buq2/audible_altimeter/README.md

# audible_altimeter

KiCad schematics for electronic skydiving altimeter.

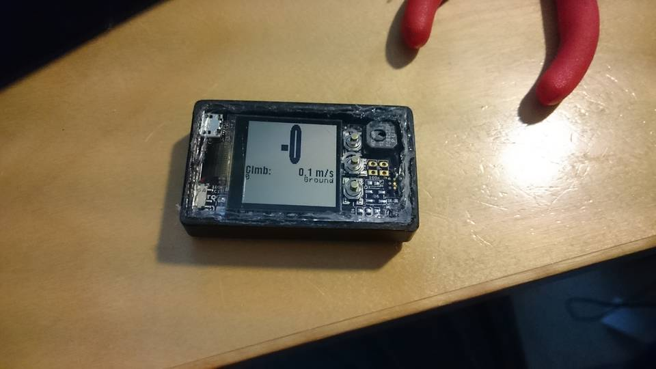
[picture p1: images/small_case13.jpg]

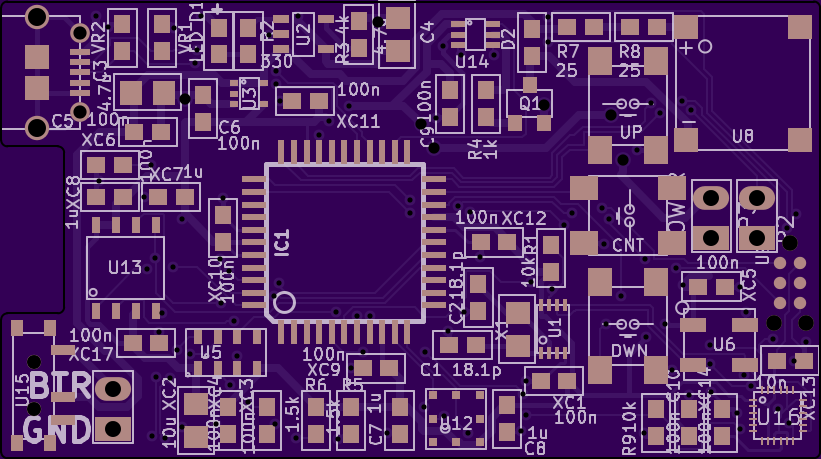
[picture p2: images/i.png]

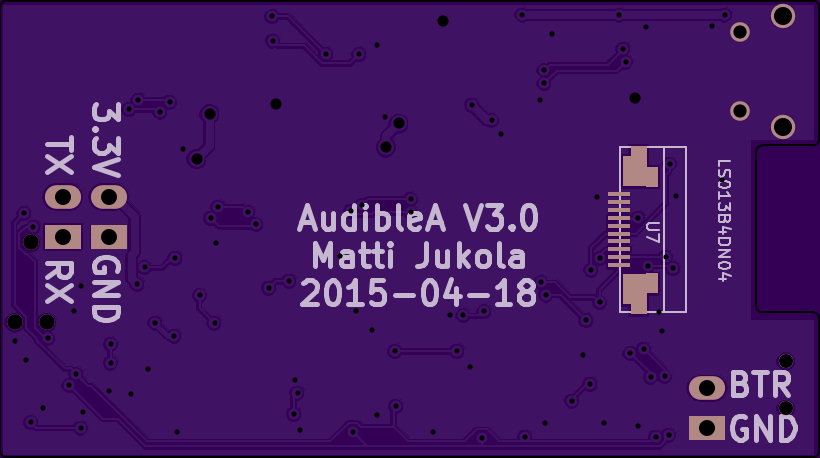
[picture p3: images/i2.png]


More information at http://buq2.com/
