buq2/audible_altimeter/case/readme.txt

http://www.makercase.com/

Thickness 1 - Inside
Width 30
Height 11.5
Depth 53
Finger
Tab width 2mm
Line stroke width 0.01
Laser cutting Kerf 0 / 0.1 / 0.15 mm
Line Color: #0000FF
Ok
