buq2/audible_altimeter/audible_altimeter.kicad_pcb

## KiCad design audible_altimeter.kicad_pcb (2016-03-05)

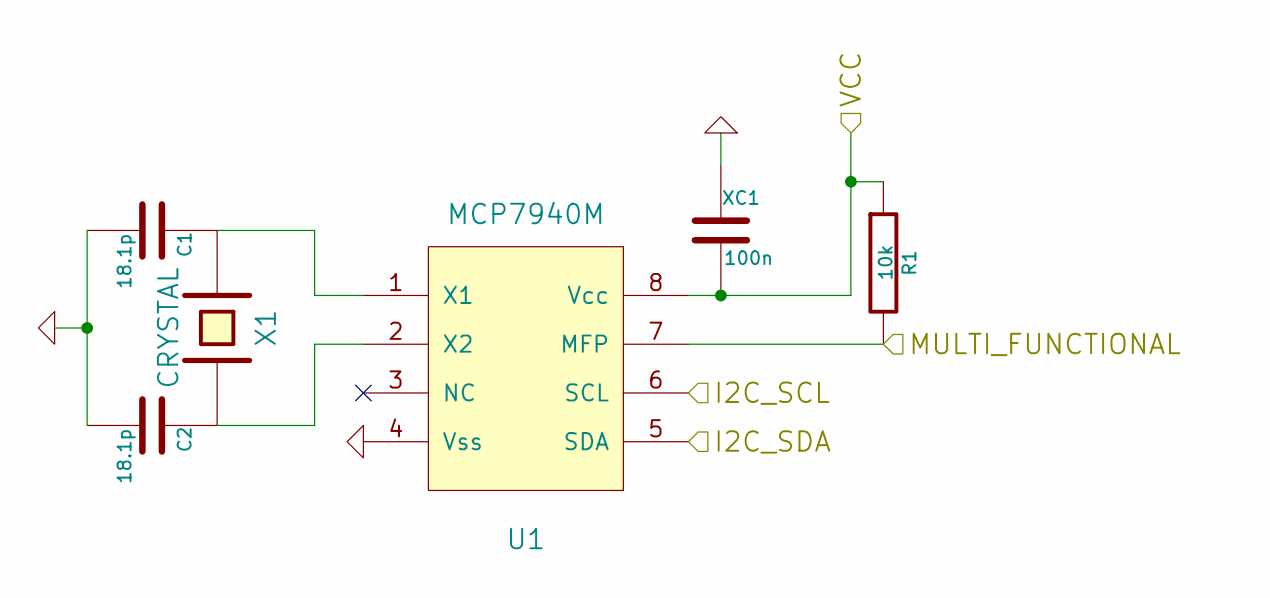
[picture p4: schematic clock.sch]

Parts:
C1, C2: 18.1p; SM0603
R1: 10k; SM0603
U1: MCP7940M; 8-TDFN
X1: CRYSTAL; SM0805
XC1: 100n; SM0603

Connections:
/Barometer/I2C_SCL: U1.6 (SCL); also elsewhere on the board
/Barometer/I2C_SDA: U1.5 (SDA); also elsewhere on the board
/Battery/+3.3V: R1.1, U1.8 (Vcc), XC1.2; also elsewhere on the board
/MCU/CLOCK_INT: R1.2, U1.7 (MFP); also elsewhere on the board
GND: C1.2, C2.2, U1.4 (Vss), XC1.1; also elsewhere on the board
unnamed: C1.1, U1.1 (X1), X1.1
unnamed: C2.1, U1.2 (X2), X1.2

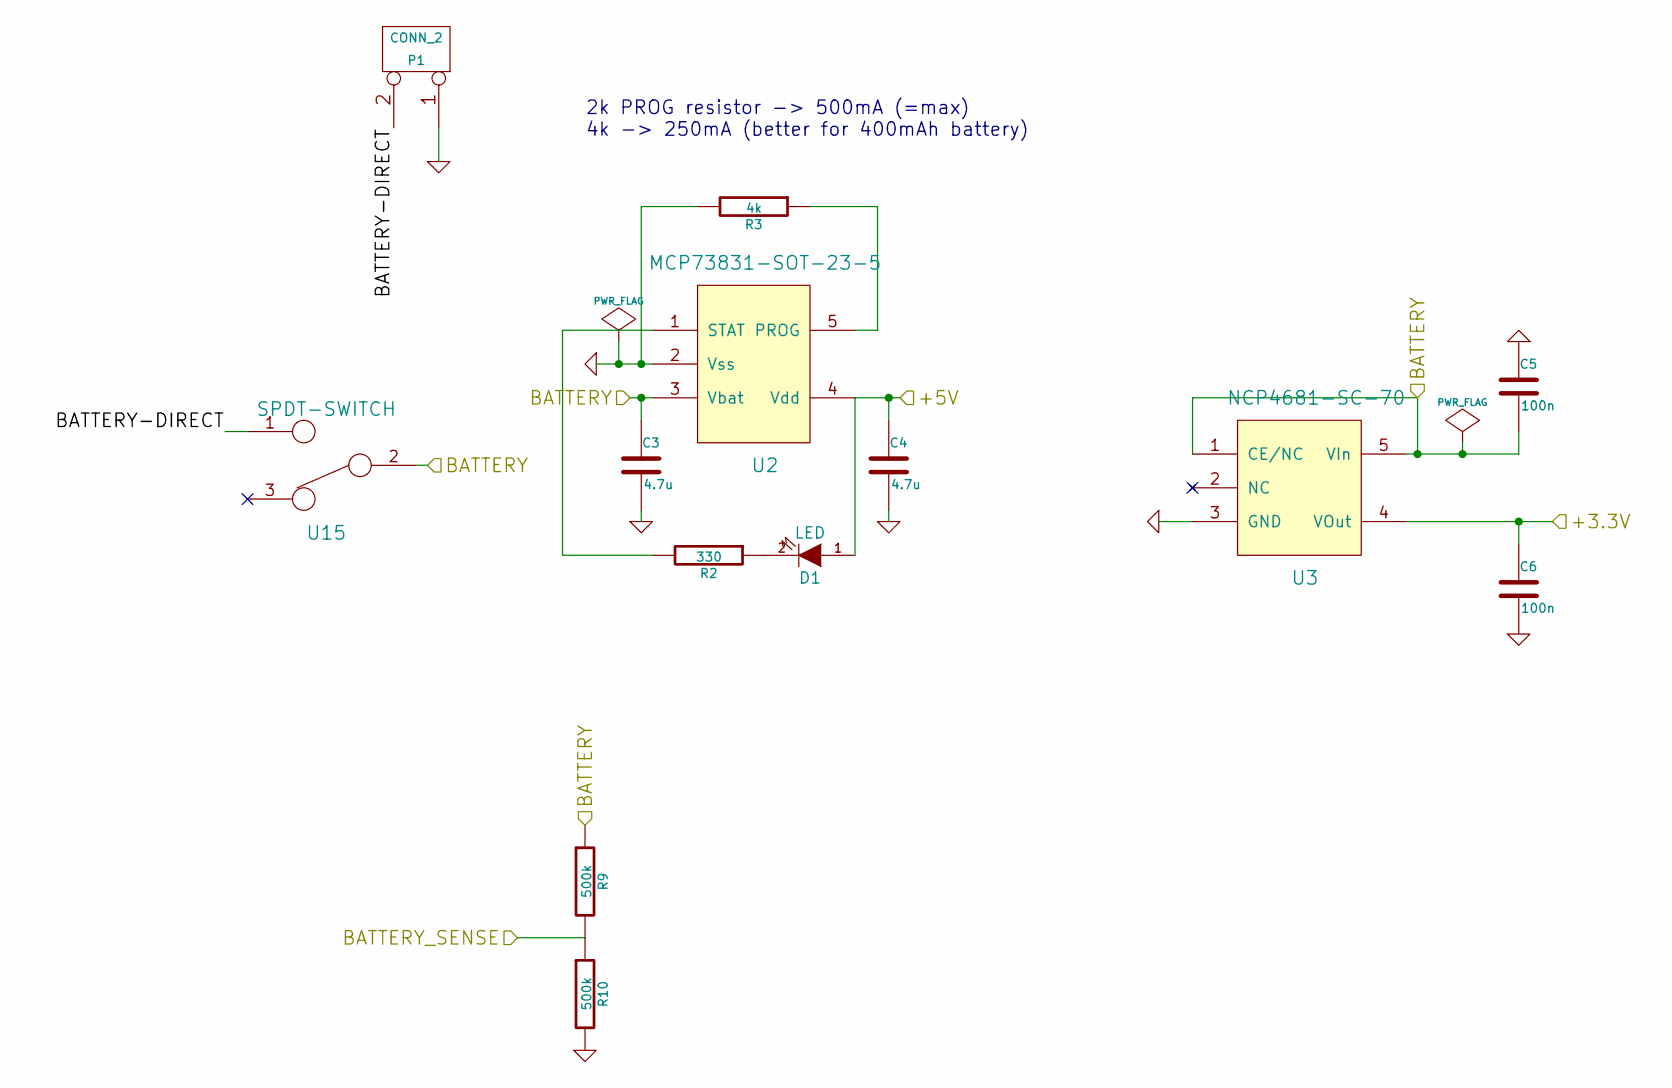
[picture p5: schematic batter.sch]

Parts:
C3, C4: 4.7u; SM0805
C5, C6: 100n; SM0603
D1: LED; SM0603
P1: CONN_2; PIN_HEADER_2
R2: 330; SM0603
R3: 4k; SM0603
R9, R10: 500k; SM0603
U2: MCP73831-SOT-23-5; SOT-23-5
U3: NCP4681-SC-70; SOT-353
U15: SPDT-SWITCH; CUS-12TB-SWITCH

Connections:
/Battery/+3.3V: C6.1, U3.4 (VOut); also elsewhere on the board
/Battery/+5V: C4.1, D1.1 (A), U2.4 (Vdd); also elsewhere on the board
/Battery/BATTERY: C3.1, C5.2, R9.1, U2.3 (Vbat), U3.1 (CE/NC), U3.5 (VIn), U15.2; also elsewhere on the board
/Battery/BATTERY-DIRECT: P1.2 (PM), U15.1
/Battery/BATTERY_SENSE: R9.2, R10.1; also elsewhere on the board
GND: C3.2, C4.2, C5.1, C6.2, P1.1, R3.2, R10.2, U2.2 (Vss), U3.3 (GND); also elsewhere on the board
unnamed: D1.2 (K), R2.1
unnamed: R2.2, U2.1 (STAT)
unnamed: R3.1, U2.5 (PROG)

Notes on the sheet:
2k PROG resistor -> 500mA (=max) 4k -> 250mA (better for 400mAh battery)

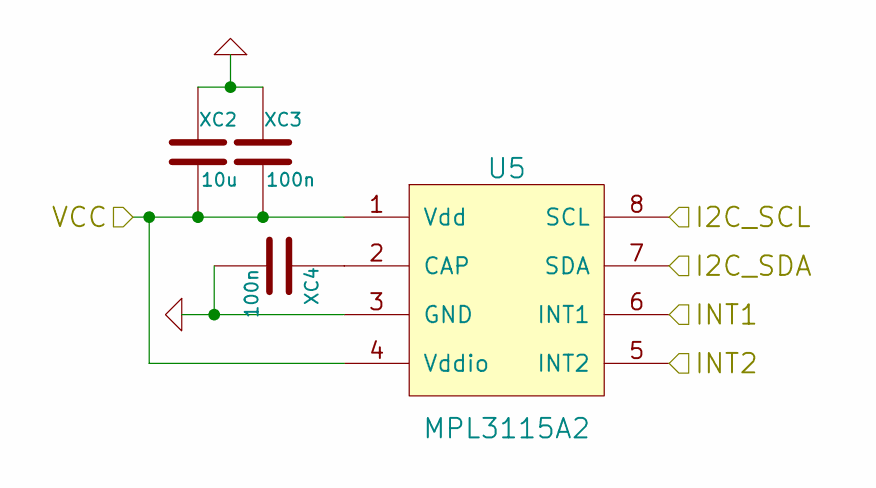
[picture p6: schematic barometer.sch]

Parts:
U5: MPL3115A2; 8-TLGA
XC2: 10u; SM0805
XC3, XC4: 100n; SM0603

Connections:
/Barometer/I2C_SCL: U5.8 (SCL); also elsewhere on the board
/Barometer/I2C_SDA: U5.7 (SDA); also elsewhere on the board
/Battery/+3.3V: U5.1 (Vdd), U5.4 (Vddio), XC2.2, XC3.2; also elsewhere on the board
/MCU/BAROMETER_INT: U5.6 (INT1); also elsewhere on the board
GND: U5.3 (GND), XC2.1, XC3.1, XC4.2; also elsewhere on the board
unnamed: U5.2 (CAP), XC4.1

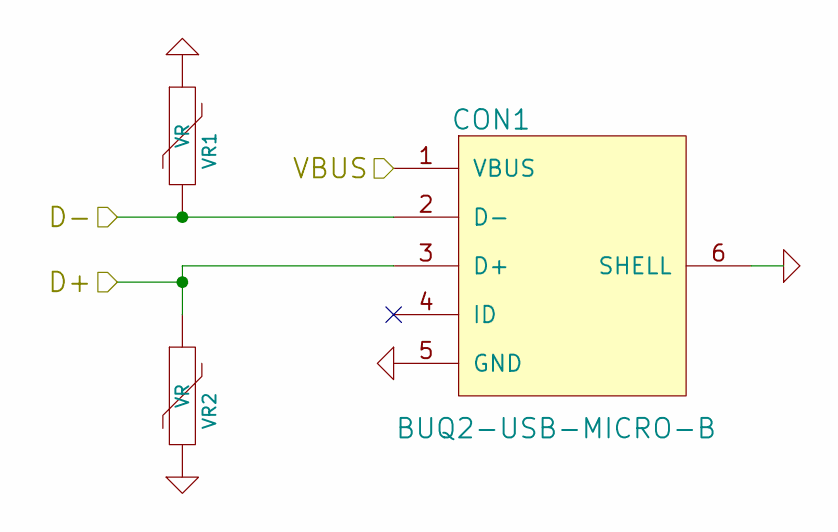
[picture p7: schematic usb.sch]

Parts:
CON1: BUQ2-USB-MICRO-B; USB-MICRO-B-FCI-10118194; Digikey 609-4616-1-ND
VR1, VR2: VR; SM0603

Connections:
/Battery/+5V: CON1.1 (VBUS); also elsewhere on the board
/MCU/D+: CON1.3 (D+), VR2.1; also elsewhere on the board
/MCU/D-: CON1.2 (D-), VR1.2; also elsewhere on the board
GND: CON1.5 (GND), CON1.6 (SHELL), VR1.1, VR2.2; also elsewhere on the board

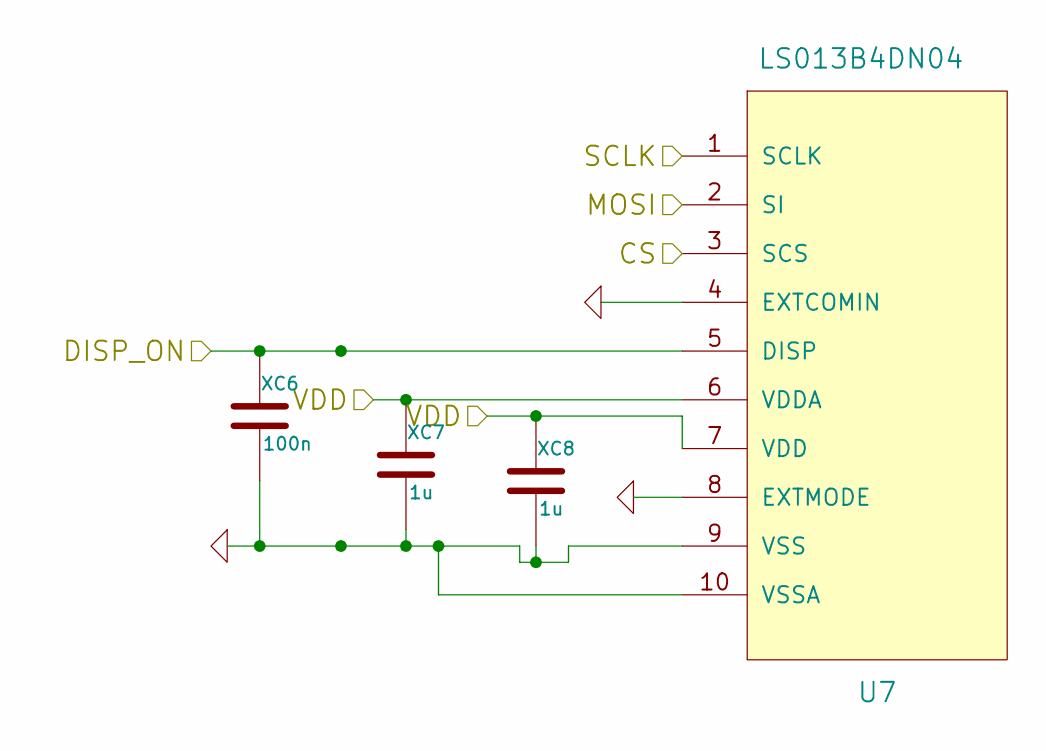
[picture p8: schematic display.sch]

Parts:
U7: LS013B4DN04; FPC-CONN-10-FCI-TOP-CONTACTS
XC6: 100n; SM0603
XC7, XC8: 1u; SM0603

Connections:
/Battery/+3.3V: U7.6 (VDDA), U7.7 (VDD), XC7.1, XC8.1; also elsewhere on the board
/Display/CS: U7.3 (SCS); also elsewhere on the board
/Display/DISP_ON: U7.5 (DISP), XC6.1; also elsewhere on the board
/Display/MOSI: U7.2 (SI); also elsewhere on the board
/MCU/SCK: U7.1 (SCLK); also elsewhere on the board
GND: U7.4 (EXTCOMIN), U7.8 (EXTMODE), U7.9 (VSS), U7.10 (VSSA), XC6.2, XC7.2, XC8.2; also elsewhere on the board

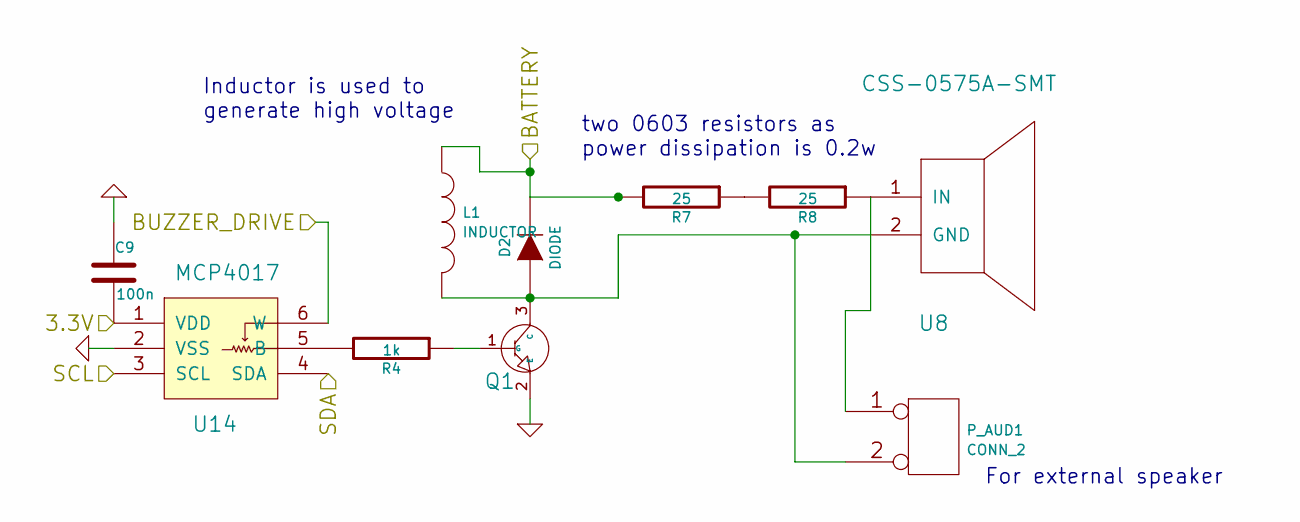
[picture p9: schematic buzzer.sch]

Parts:
C9: 100n; SM0603
D2: DIODE; SM0603
L1: INDUCTOR
P_AUD1: CONN_2
Q1: NPN-SOT23; SOT-23-3
R4: 1k; SM0603
R7, R8: 25; SM0603
U8: CSS-0575A-SMT; BUZZER-CUI-5MM
U14: MCP4017; SC-70-6

Connections:
/Barometer/I2C_SCL: U14.3 (SCL); also elsewhere on the board
/Barometer/I2C_SDA: U14.4 (SDA); also elsewhere on the board
/Battery/+3.3V: C9.2, U14.1 (VDD); also elsewhere on the board
/Battery/BATTERY: D2.2 (K), L1.1, R7.2; also elsewhere on the board
/Buzzer/BUZZER_DRIVE: U14.6 (W); also elsewhere on the board
GND: C9.1, Q1.2 (E), U14.2 (VSS); also elsewhere on the board
unnamed: D2.1 (A), L1.2, P_AUD1.2 (PM), Q1.3 (C), U8.2 (GND)
unnamed: Q1.1 (G), R4.1
unnamed: R4.2, U14.5 (B)
unnamed: R7.1, R8.2
unnamed: P_AUD1.1, R8.1, U8.1 (IN)

Notes on the sheet:
two 0603 resistors as power dissipation is 0.2w
For external speaker
Inductor is used to generate high voltage

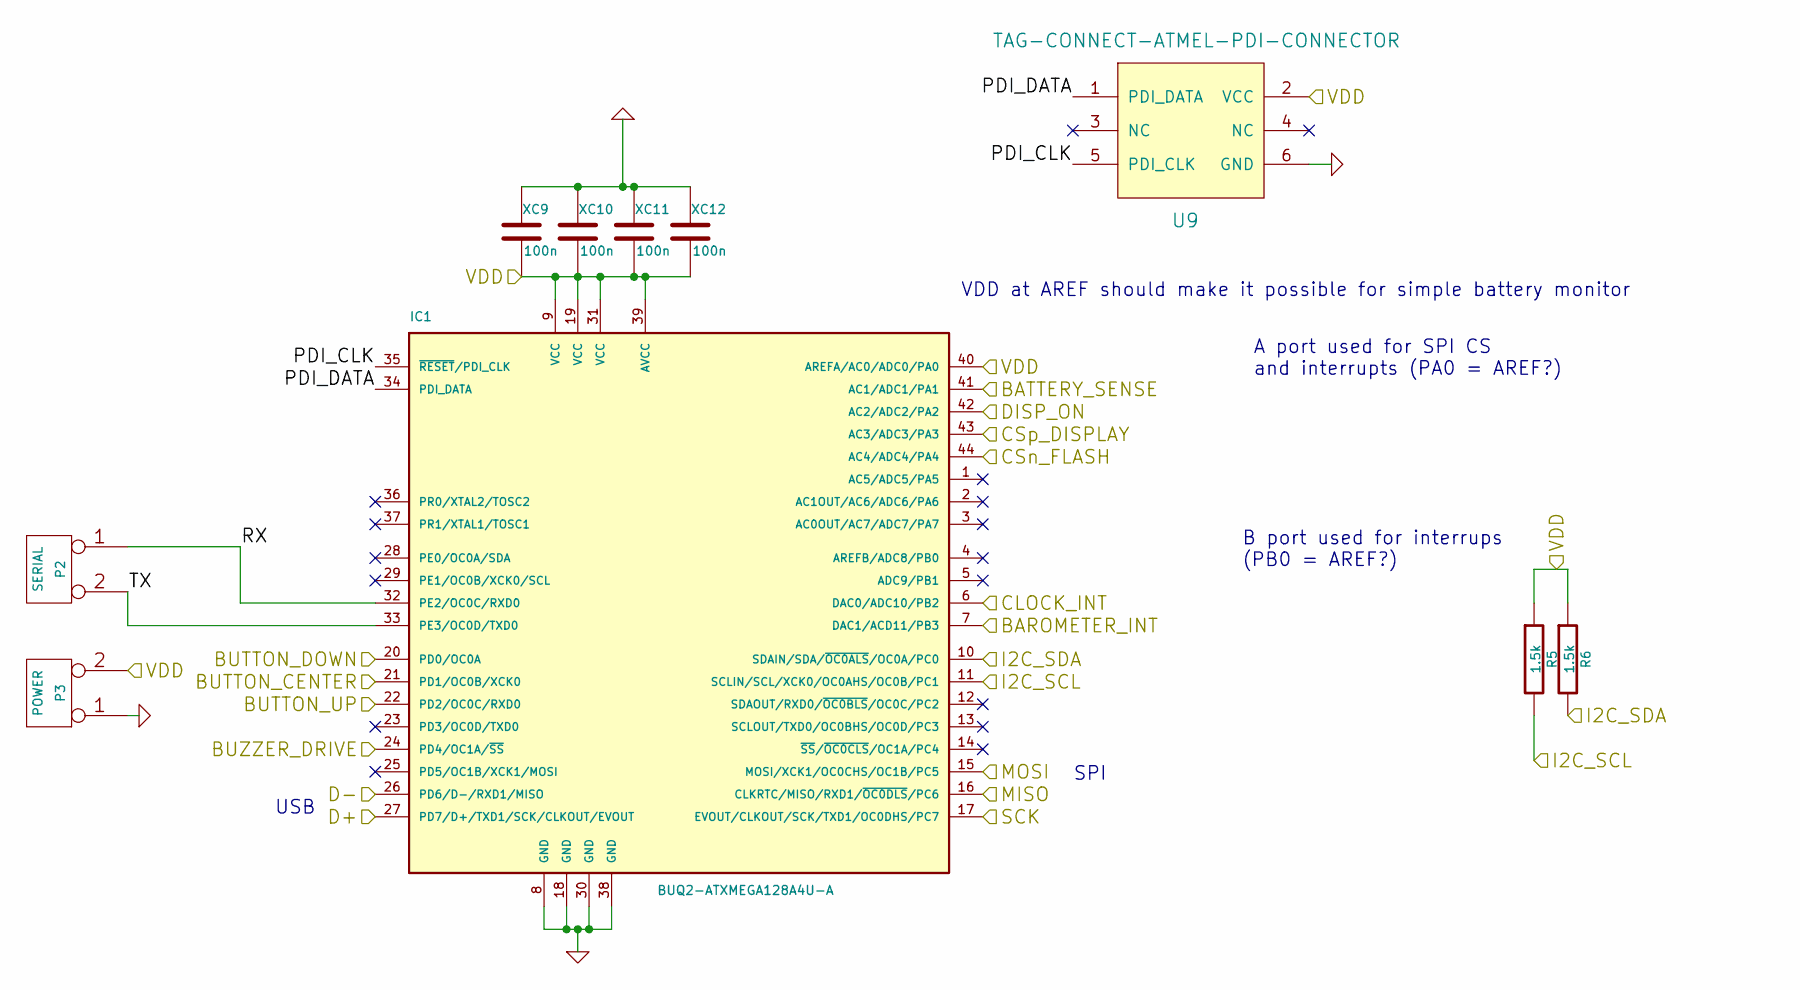
[picture p10: schematic mcu.sch]

Parts:
IC1: BUQ2-ATXMEGA128A4U-A; BUQ2-TQFP44
P2: SERIAL; PIN_HEADER_2
P3: POWER; PIN_HEADER_2
R5, R6: 1.5k; SM0603
U9: TAG-CONNECT-ATMEL-PDI-CONNECTOR; TAG-CONNECT6
XC9, XC10, XC11, XC12: 100n; SM0603

Connections:
/Barometer/I2C_SCL: IC1.11 (SCLIN/SCL/XCK0/OC0AHS/OC0B/PC1), R5.2; also elsewhere on the board
/Barometer/I2C_SDA: IC1.10 (SDAIN/SDA/~OC0ALS~/OC0A/PC0), R6.2; also elsewhere on the board
/Battery/+3.3V: IC1.9 (VCC), IC1.19 (VCC), IC1.31 (VCC), IC1.39 (AVCC), IC1.40 (AREFA/AC0/ADC0/PA0), P3.2 (PM), R5.1, R6.1, U9.2 (VCC), XC9.2, XC10.2, XC11.2, XC12.2; also elsewhere on the board
/Battery/BATTERY_SENSE: IC1.41 (AC1/ADC1/PA1); also elsewhere on the board
/Buttons/BUTTON_CENTER: IC1.21 (PD1/OC0B/XCK0); also elsewhere on the board
/Buttons/BUTTON_DOWN: IC1.20 (PD0/OC0A); also elsewhere on the board
/Buttons/BUTTON_UP: IC1.22 (PD2/OC0C/RXD0); also elsewhere on the board
/Buzzer/BUZZER_DRIVE: IC1.24 (PD4/OC1A/~SS~); also elsewhere on the board
/Display/CS: IC1.43 (AC3/ADC3/PA3); also elsewhere on the board
/Display/DISP_ON: IC1.42 (AC2/ADC2/PA2); also elsewhere on the board
/Display/MOSI: IC1.15 (MOSI/XCK1/OC0CHS/OC1B/PC5); also elsewhere on the board
/MCU/BAROMETER_INT: IC1.7 (DAC1/ACD11/PB3); also elsewhere on the board
/MCU/CLOCK_INT: IC1.6 (DAC0/ADC10/PB2); also elsewhere on the board
/MCU/CSn_FLASH: IC1.44 (AC4/ADC4/PA4); also elsewhere on the board
/MCU/D+: IC1.27 (PD7/D+/TXD1/SCK/CLKOUT/EVOUT); also elsewhere on the board
/MCU/D-: IC1.26 (PD6/D-/RXD1/MISO); also elsewhere on the board
/MCU/MISO: IC1.16 (CLKRTC/MISO/RXD1/~OC0DLS~/PC6); also elsewhere on the board
/MCU/PDI_CLK: IC1.35 (~RESET~/PDI_CLK), U9.5 (PDI_CLK)
/MCU/PDI_DATA: IC1.34 (PDI_DATA), U9.1 (PDI_DATA)
/MCU/RX: IC1.32 (PE2/OC0C/RXD0), P2.1
/MCU/SCK: IC1.17 (EVOUT/CLKOUT/SCK/TXD1/OC0DHS/PC7); also elsewhere on the board
/MCU/TX: IC1.33 (PE3/OC0D/TXD0), P2.2 (PM)
GND: IC1.8 (GND), IC1.18 (GND), IC1.30 (GND), IC1.38 (GND), P3.1, U9.6 (GND), XC9.1, XC10.1, XC11.1, XC12.1; also elsewhere on the board

Notes on the sheet:
SPI
USB
A port used for SPI CS and interrupts (PA0 = AREF?)
B port used for interrups (PB0 = AREF?)
VDD at AREF should make it possible for simple battery monitor

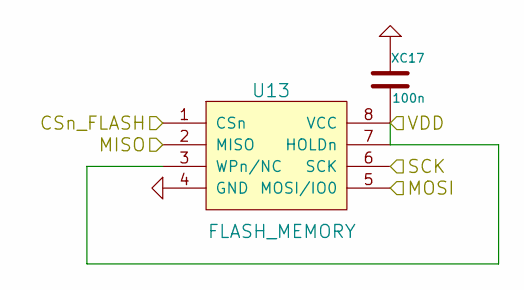
[picture p11: schematic memory.sch]

Parts:
U13: FLASH_MEMORY; 8-SOIC
XC17: 100n; SM0603

Connections:
/Battery/+3.3V: U13.3 (WPn/NC), U13.7 (HOLDn), U13.8 (VCC), XC17.2; also elsewhere on the board
/Display/MOSI: U13.5 (MOSI/IO0); also elsewhere on the board
/MCU/CSn_FLASH: U13.1 (CSn); also elsewhere on the board
/MCU/MISO: U13.2 (MISO); also elsewhere on the board
/MCU/SCK: U13.6 (SCK); also elsewhere on the board
GND: U13.4 (GND), XC17.1; also elsewhere on the board

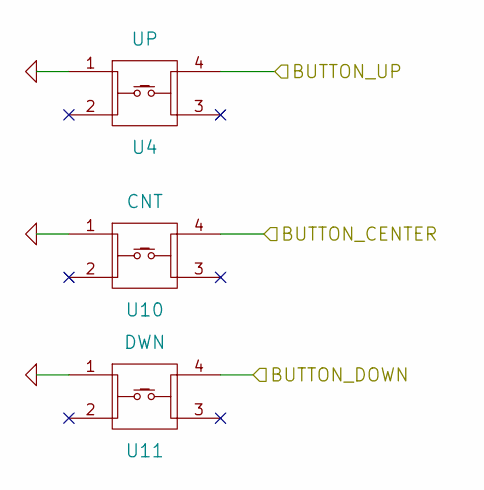
[picture p12: schematic buttons.sch]

Parts:
U4: UP; PUSHBUTTON_4x4_5x5_ROTATED_4_PIN
U10: CNT; PUSHBUTTON_4x4_5x5_ROTATED_4_PIN
U11: DWN; PUSHBUTTON_4x4_5x5_ROTATED_4_PIN

Connections:
/Buttons/BUTTON_CENTER: U10.4; also elsewhere on the board
/Buttons/BUTTON_DOWN: U11.4; also elsewhere on the board
/Buttons/BUTTON_UP: U4.4; also elsewhere on the board
GND: U4.1, U10.1, U11.1; also elsewhere on the board

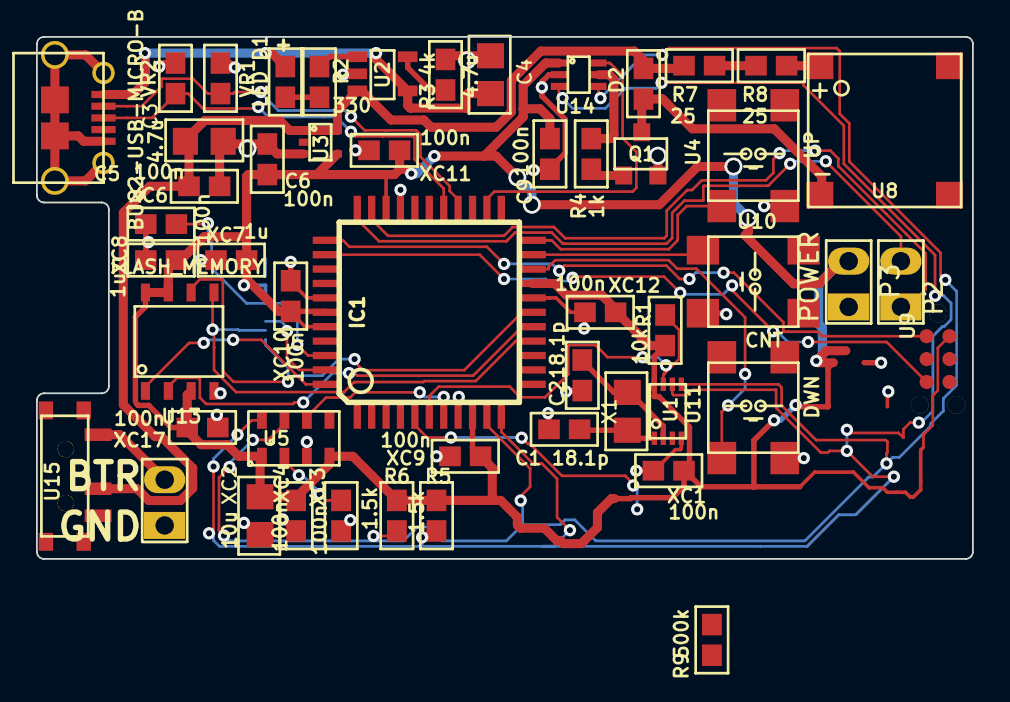
[picture p13: board audible_altimeter.kicad_pcb from above]

Board: 2 copper layers, 52.0 x 29.0 mm, 52 parts (1 on the bottom side), 37 nets.
