buq2/audible_altimeter/(commit log)

2014-10-19 Component assignements
    [$audible_altimeter.sch, audible_altimeter.sch]
2014-10-20 Start adding power components
    [audible_altimeter.kicad_pcb, audible_altimeter.sch]
2014-10-21 Assign some components
    [audible_altimeter.sch]
2014-10-21 Start using hierarchical sheets
    [9axis.sch, audible_altimeter.sch, barometer.sch, batter.sch, buzzer.sch, clock.sch, display.sch, mcu.sch]
2014-11-10 Add gps
    [9axis.sch, audible_altimeter.kicad_pcb, audible_altimeter.sch, barometer.sch, batter.sch, buzzer.sch, clock.sch, display.sch]
2014-11-11 Add humidity sensor
    [9axis.sch, audible_altimeter.kicad_pcb, audible_altimeter.sch, barometer.sch, batter.sch, buzzer.sch, clock.sch, display.sch]
2014-11-11 More connections
    [9axis.sch, audible_altimeter.sch, barometer.sch, batter.sch, buzzer.sch, clock.sch, display.sch, gps.sch]
2014-11-12 Add flash and ram. Some connections and DRC cleaning
    [9axis.sch, audible_altimeter.sch, barometer.sch, batter.sch, buzzer.sch, clock.sch, display.sch, gps.sch]
2014-11-12 Add buttons. Fix DRC. Add antenna
    [9axis.sch, audible_altimeter.kicad_pcb, audible_altimeter.sch, barometer.sch, batter.sch, buttons.sch, buzzer.sch, clock.sch]
2014-11-12 Start first layout test
    [audible_altimeter.kicad_pcb, barometer.sch, buttons.sch, clock.sch, display.sch, gps.sch, memory.sch, usb.sch]
2014-11-13 Little bit layout
    [audible_altimeter.kicad_pcb, mcu.sch]
2014-11-15 Some easy routing
    [audible_altimeter.kicad_pcb]
2014-11-29 Before making larger board. - Changed GPS module
    [9axis.sch, audible_altimeter.kicad_pcb, buttons.sch, gps.sch, humidity.sch, mcu.sch, memory.sch]
2014-11-30 Before adding proper reset and battery monitor
    [audible_altimeter.kicad_pcb, buttons.sch, gps.sch, mcu.sch]
2014-11-30 V1 version which was ordered
    [audible_altimeter.kicad_pcb]
2015-01-26 Start planning test board v2.0
    [9axis.sch, audible_altimeter.kicad_pcb, audible_altimeter.sch, barometer.sch, batter.sch, buttons.sch, buzzer.sch, clock.sch]
2015-01-27 Almost ready routing
    [audible_altimeter.kicad_pcb, buzzer.sch, mcu.sch]
2015-01-27 Add new barometer
    [audible_altimeter.kicad_pcb, barometer.sch, batter.sch, buttons.sch, buzzer.sch, clock.sch, display.sch, mcu.sch]
2015-01-27 Ordered version 2.0 (pcb and stencil)
    [audible_altimeter.kicad_pcb, barometer.sch, batter.sch, buttons.sch, buzzer.sch, clock.sch, display.sch, mcu.sch]
2015-01-27 Remove deleted schematics
    [9axis.sch, gps.sch, humidity.sch, micro_sd.sch]
2015-02-03 Case: Before difference
2015-02-03 With 0,1,1.5mm kerf
2015-02-03 Some modifications to the case
2015-02-03 Add readme about the case
2015-02-05 Modify such that the manufacturer accepts the file (formulor.de)
2015-04-15 Start implementing new version: move USB port and altimeter module, new buzzer and volume control
    [audible_altimeter.kicad_pcb, audible_altimeter.sch, batter.sch, buttons.sch, buzzer.sch, mcu.sch, memory.sch]
2015-04-17 Before starting laying out tracks
    [accelerometer.sch, audible_altimeter.kicad_pcb, audible_altimeter.sch, barometer.sch, batter.sch, buttons.sch, buzzer.sch, clock.sch]
2015-04-18 Continuing laying out tracks
    [accelerometer.sch, audible_altimeter.kicad_pcb, barometer.sch, batter.sch, buttons.sch, buzzer.sch, clock.sch, display.sch]
2015-04-18 Ordered v3.0
    [accelerometer.sch, audible_altimeter.kicad_pcb, barometer.sch, batter.sch, buttons.sch, buzzer.sch, clock.sch, display.sch]
2015-04-18 Change few footprints to ones with (simple) 3d models
    [audible_altimeter.kicad_pcb]
2016-03-05 Some changes?
    [audible_altimeter.kicad_pcb, audible_altimeter.sch, barometer.sch, batter.sch, buttons.sch, buzzer.sch, clock.sch, display.sch]
2022-03-15 Add board images
